AndreaBononi/MotionDetector/README.md

# MotionDetector
Motion detector board based on a PIR sensor
