AndreaBononi/MotionDetector/MotionDetector_technical_report.pdf

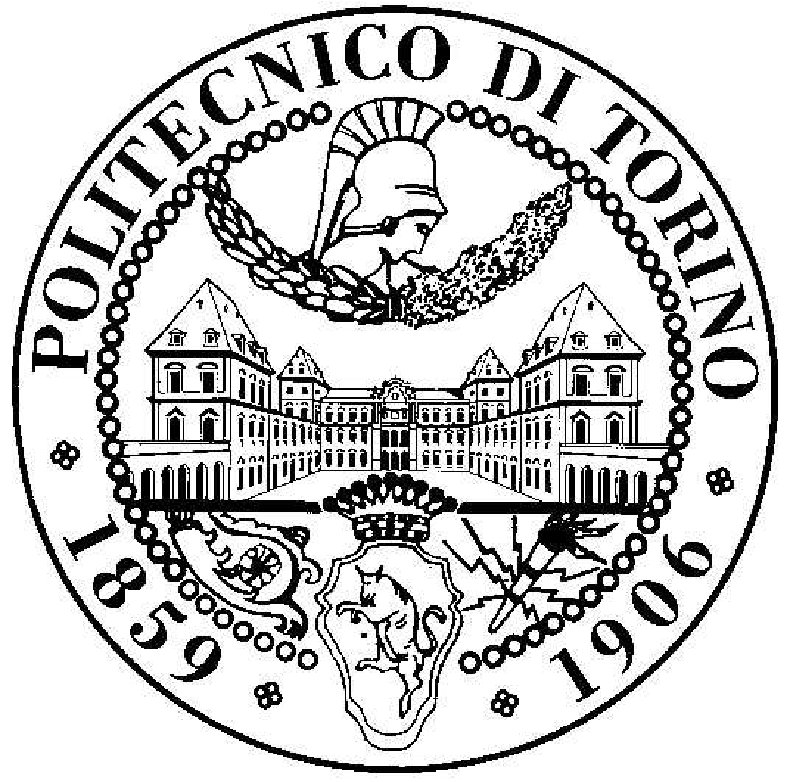
[picture p1: figure]

# Politecnico di Torino

## Electronic Systems Engineering

# ABDM ALARM

## BLUETOOTH MOTION DETECTOR WITH ACOUSTIC WARNING

## Author: Bononi Andrea (287628)

# CONTENTS

1 DEVICE OVERVIEW | 2
2 BILL OF MATERIALS | 4
3 SCHEMATICS | 5
4 BOARD LAYOUT | 10
5 CURRENT CONSUMPTION | 13
6 PRODUCTION COST ESTIMATION | 16
7 DESIGN HISTORY | 17

# DEVICE OVERVIEW

## 1.1 Description

The ABDM device is a cost-effective low power wireless intruder detector. When a movement is detected, an acoustic alarm is activated and a notice is immediately sent via Bluetooth to a dedicated Android application, from which it is possible to deactivate it (otherwise it will last 5 minutes once activated).

The detector can be enabled and disabled from the Android application. It can also be configured to automatically send an alert to a police station or to a specific phone number when an intrusion is detected.

The system is battery-powered. It is rechargeable by means of a common micro-USB connector and the battery status can be visualized in the Android application. A notification is sent when the battery charge level falls under a minimum threshold.

The Android application is called ABDM alarm, it can be downloaded for free from the offical Play Store and it can be periodically updated to newer versions (therefore, other functionalities may be developed in future without the need of changing the device).

## 1.2 Features

- Ultra-low power device
- Infrared movement detection

– Long distance detection (up to 7m) – Large field of view (90°)

- Battery-powered system

– 6 days duration

– Micro-USB connector for battery charge

– Capability of working while on charge

- BLE communication by means of a free Android application

– Immediate notification of a movement detection
– Capability of enabling/disabling the detection

– Battery charge status indication
– Immediate notification when the battery charge level falls under 10%
- Acoustic alarm

– 82db acoustic sound
– Automatic deactivation after 5 minutes
- Manual shutdown (mechanical switch) and reset (mechanical pushbutton)
- Device protection

– The switch and the pushbutton can be reached only by opening the device package
– The device package can only be opened with a suitable key (provided within the device itself)

CHAPTER 1. DEVICE OVERVIEW

## 1.3 Functional Block Diagram

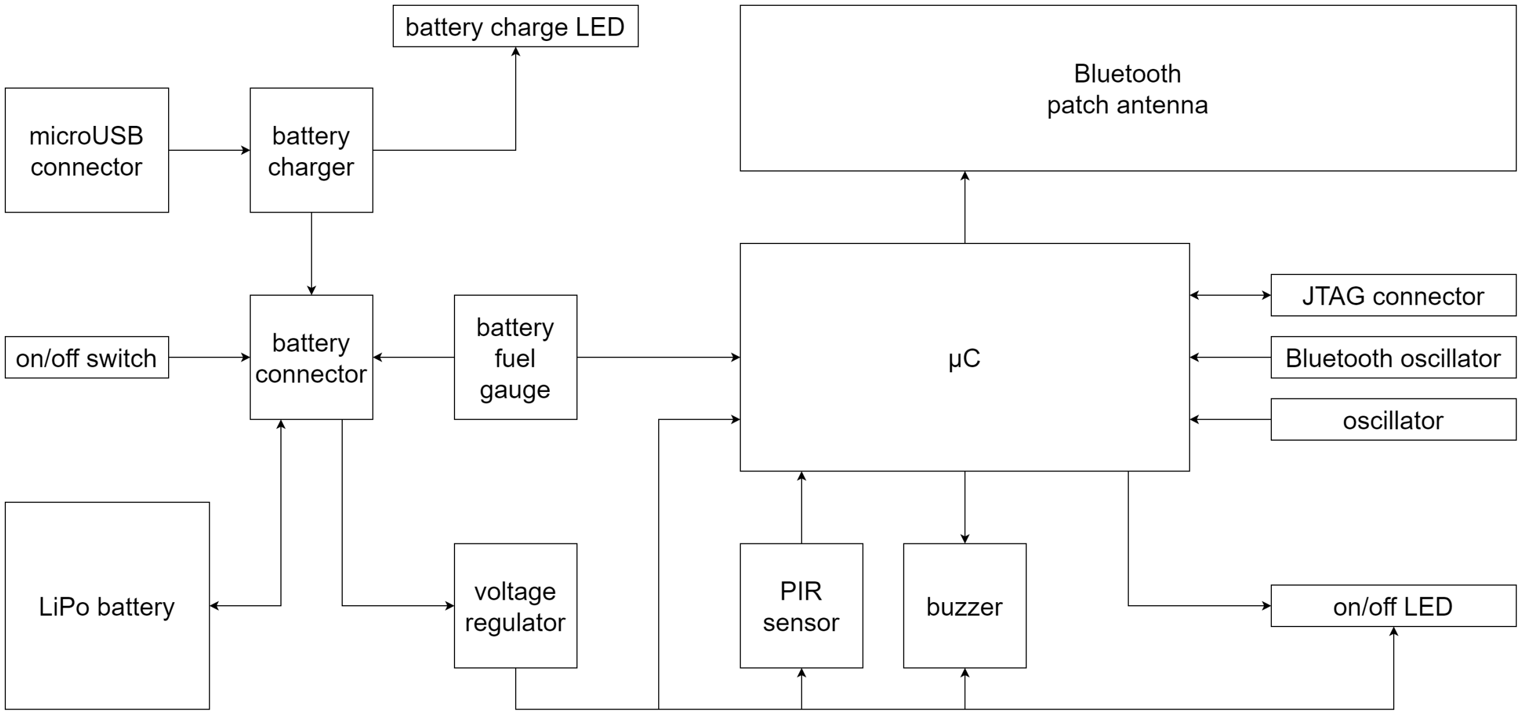
[picture p2: figure]

Figure 1.1: device functional block diagram

- An external LiPo battery is connected to the device through a battery connector and it can be recharged using an external 5V power source by means of a battery charger. The external power source is connected to the device through a microUSB connector. When the battery is on charge, the battery charge LED is turned on and the system is powered by the external source. The charge level of the battery is detected by means of a fuel gauge which communicates with the microcontroller using an I2C protocol.
- The on/off switch allows to disconnect the battery from the device, switching it off. The on/off LED is turned on when the device is powered.
- A voltage regulator (buck converter) is employed to convert the battery voltage (3.7V) or the esternal source voltage (5V) in a suitable value for the microcontroller and its external peripherals (3.3V).
- A PIR sensor is used for detecting any movement in the surrounding area (7m distance, 90° angle). The output is a simple digital signal (high if a movement is detected, low otherwise) compatible with the voltage levels of the microcontroller.
- An internally-driven electromechanical buzzer is employed to generate the acustic alarm when an intrusion is detected.
- The microcontroller is the real core of the system. It read the status of the PIR sensor and the status of the fuel gauge, it activates the buzzer when required and it manages the communication with the Android application via Bluetooth (it has an integrated BLE interface). It is programmed by means of a JTAG connector and it requires a generic esternal oscillator (24MHz) and a Bluetooth external oscillator (32.768 kHz). The BLE communication is realized using a suitable patch antenna.
- The device is incapsulated inside a safety box, which can be opened using the key provided to the customer with the device itself. The LEDs status can be seen from the otuside, but the mechanical switch cannot be reached without opening the box.

# BILL OF MATERIALS

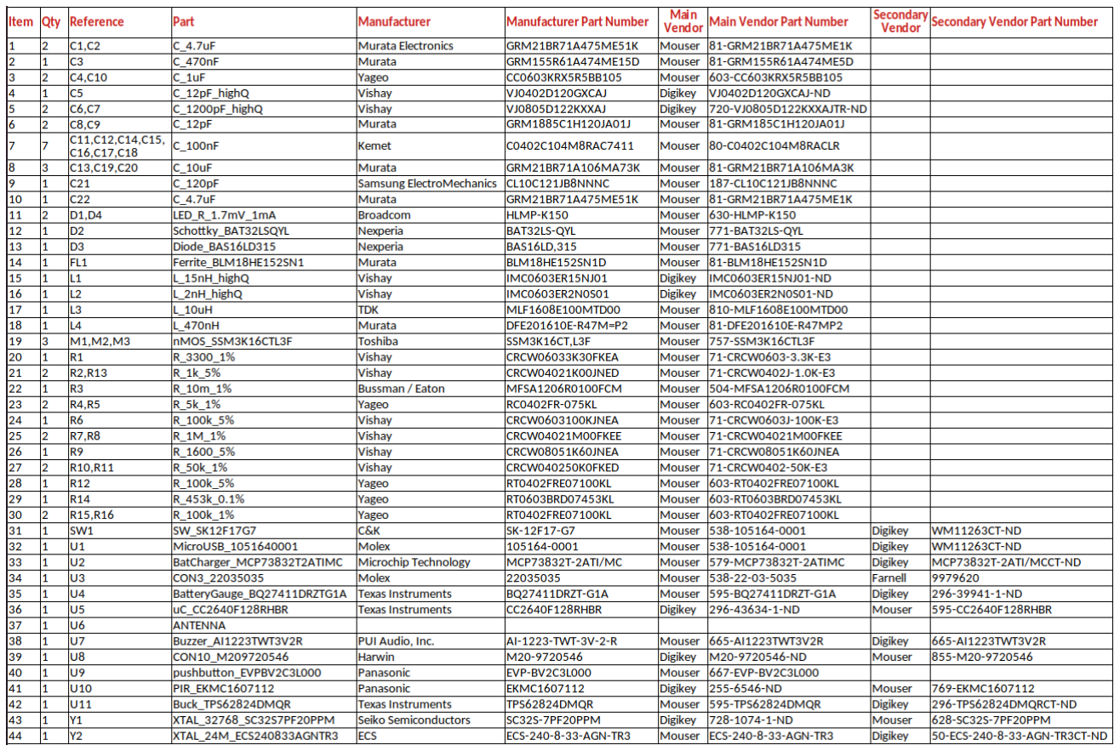
[picture p3: figure]

The previous table contains all the components employed in the board fabrication. However, it is also necessary to include in the list the battery, which is external with respect to the board but necessary to make it work:

LiPo battery (3.7 V, 980 mAh) Manufacturer: BAK
Manufacturer product number: LP-523450-IS-3 Vendor: Farnell
Vendor part number: 2077888

# SCHEMATICS

## 3.1 Battery Management Section

The battery voltage is provided to the board using a rectangular connector, whereas the charging voltage is provided by means of a micro-USB connector. When the charging voltage is present the battery is recharged, the charge LED is turned on and the system is powered by this voltage instead of the battery voltage. The battery charge level is detected by the gauge, which measures the current flowing through a sense resistor. The mechanical switch allows to disconnect the battery voltage from the rest of the circuit, turning it off.

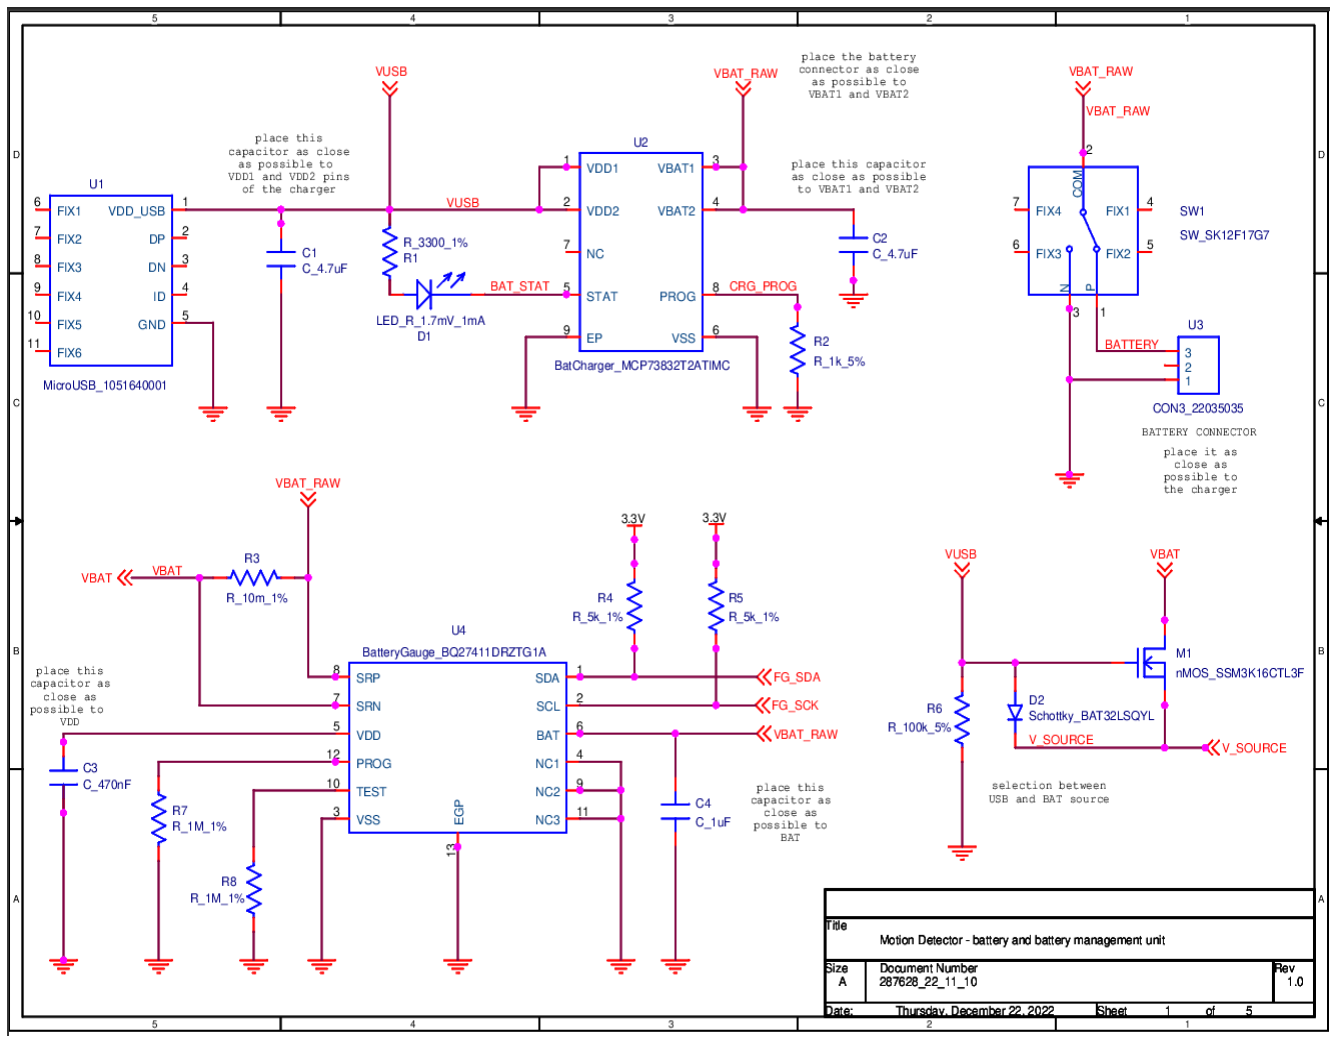
[picture p4: figure]

Figure 3.1: Battery management section

- The value of the resistor in series to the LED is such that the current flowing through it and its voltage drop are capable of turning it on. If necessary, both the LED and the resistor can be substituted with different commercial parts as long as the LED can be turned on using VUSB = 5 V and as long as the power consumption is not significantly increased.
- The MOS transistor and the Schottky diode allows the selection between the USB voltage and the battery voltage. They can be substituted with any other commercial parts as long as they are able to withstand a suitable power consumption (all the current required by the device flows through them).

CHAPTER 3. SCHEMATICS

- All the passive parts (resistors and capacitors) can be substituted with equivalent commercial parts. Their uncertainty is not really important, with the exception of the sense resistor (whose uncertainty must be equal or lower than 1%). It is recommended to use X5R or X7R decoupling capacitors.

## 3.2 Microcontroller Section

The main clock and the Bluetooth clock are provided using two suitable crystal oscillators. The RF communication is realized employing a patch antenna with a single-ended connection (4XS).

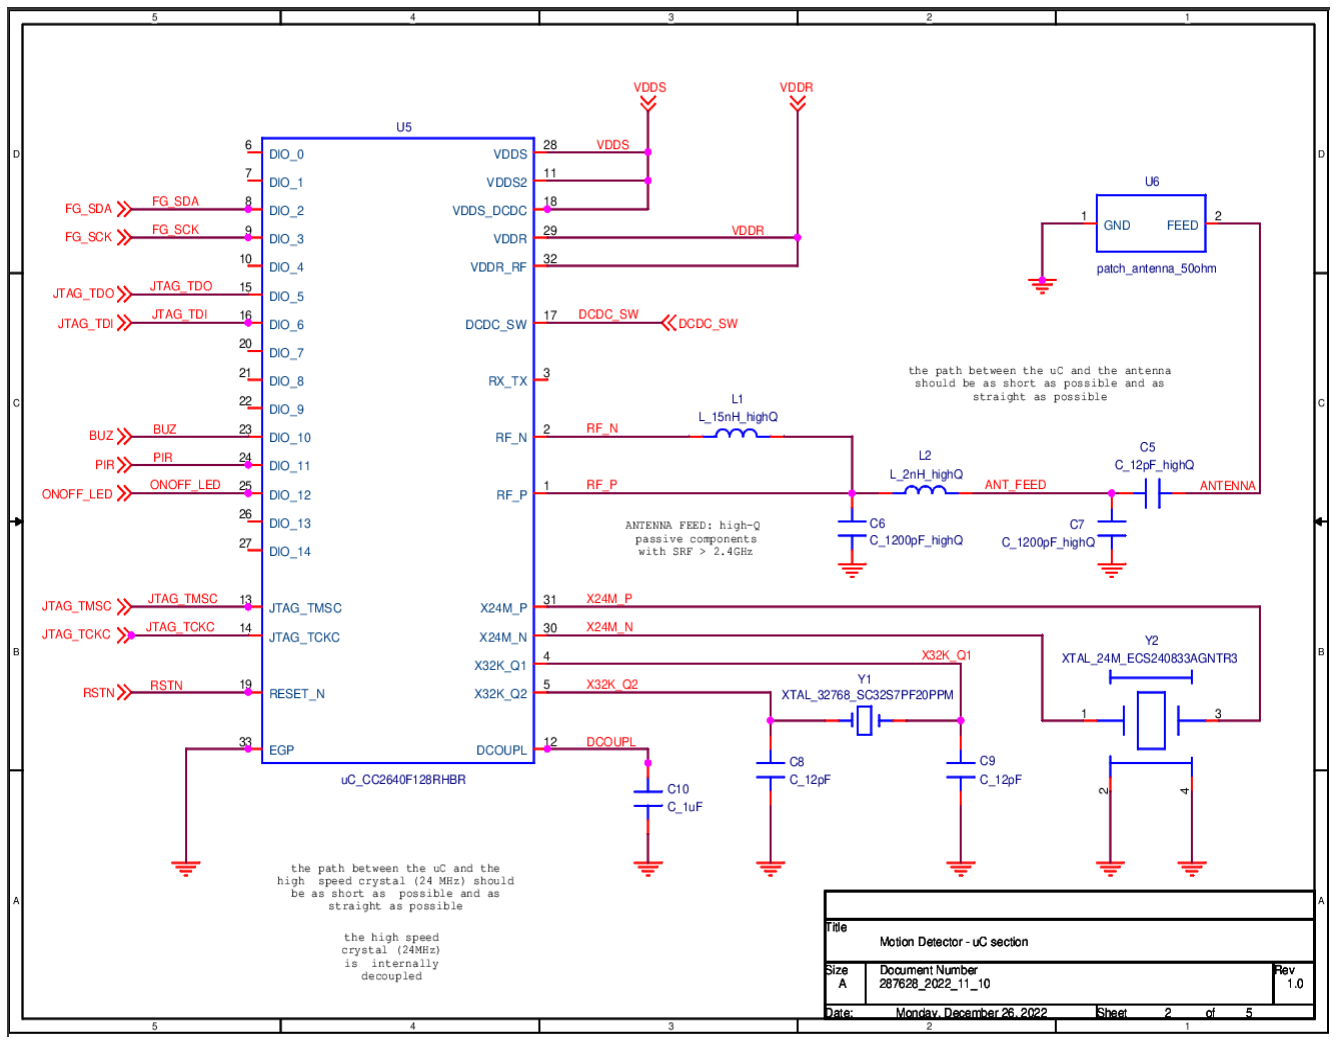
[picture p5: figure]

Figure 3.2: Microcontroller section

- The oscillators are chosen in order to respect the requirements stated by the manufacturer of the CC2640 microcontroller. They can be susbtituted with any other part which respects these requirements.
- The components employed in the antenna feed are characterized by a self-resonant frequency higher than the antenna freqeuncy (2.4 GHz) and by a high quality factor. They can be substituted with any other commercial part respecting these requirements.
- All the passive components related to the decoupling network can be substituted with equivalent commercial parts. Their uncertainty is not really important. It is recommended to use X5R or X7R capacitors.

CHAPTER 3. SCHEMATICS

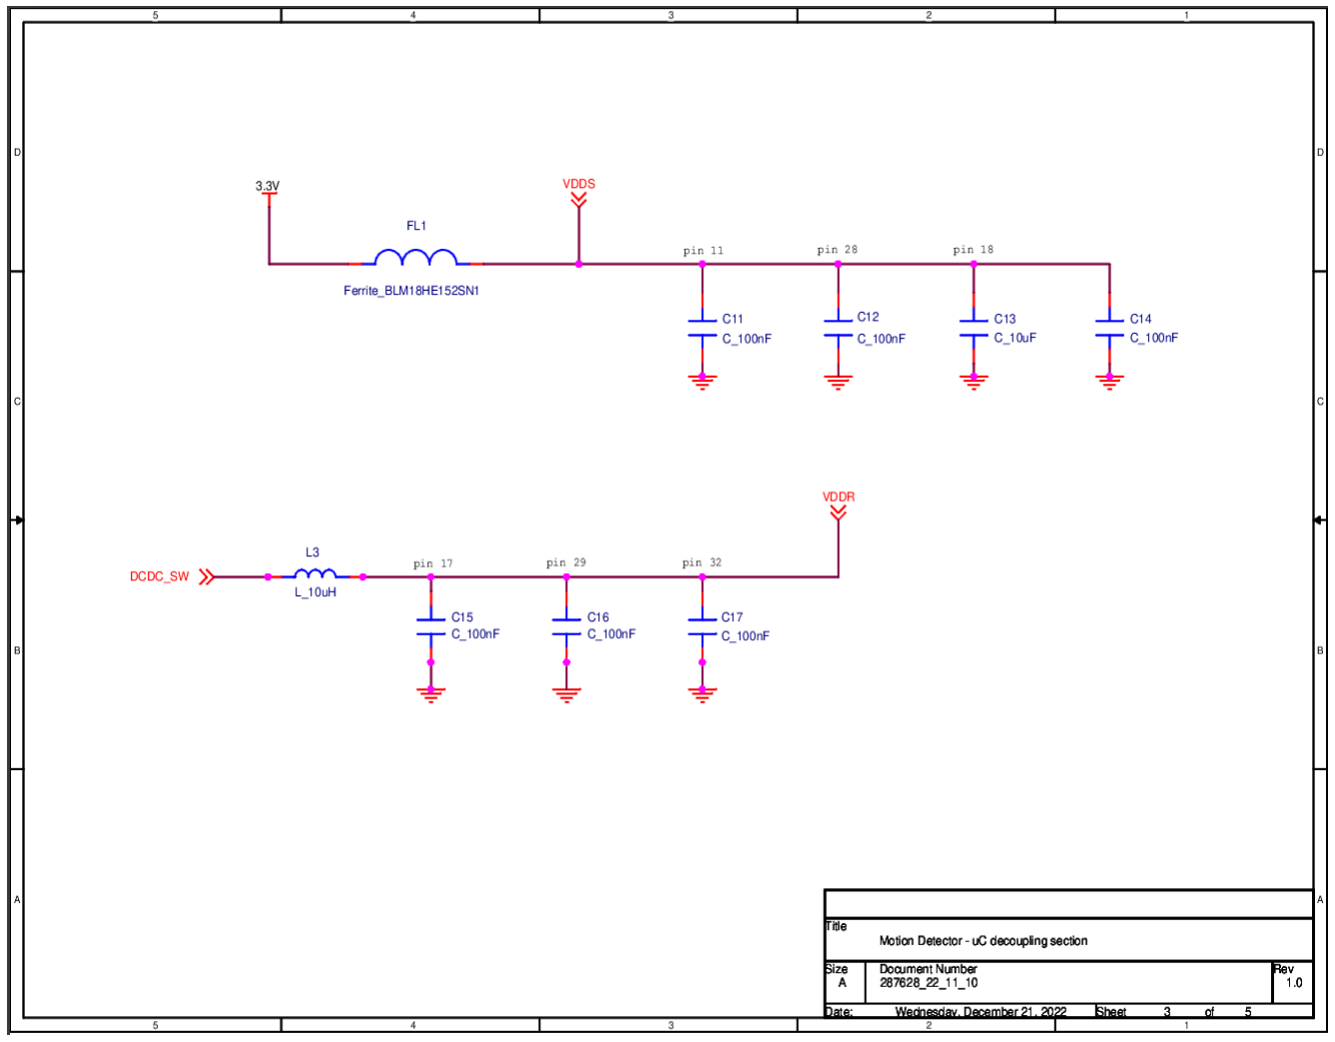
[picture p6: figure]

Figure 3.3: Microcontroller decoupling

## 3.3 Peripherals

The electromechanical buzzer is internally-driven, i.e. it just requires a continuous current in order to be activated. However, the required current is too high to be provided directly by the microcontroller, therefore a simple driver is realized exploiting a MOSFET transistor in common source configuration. A resistor is inserted in series to the transistor gate in order to limit the instantaneous current during the commutations, whereas a protecting diode is inserted in parallel to the buzzer (being it an inductive load).

Similarly to the buzzer case, the current required by the ON-OFF LED is too high, therefore the same driver is employed (without the protectiong diode, since the LED is not an inductive load). Moreover, a proper resistor is inserted in series to the LED in order to obtain the voltage drop and the current flow capable of turning it on.

The output current of the PIR sensor is perfectly maneageable by the microcontroller (since it is low enough), therefore it is not necessary to insert any other circuit.

The microcontroller programming is managed through a JTAG connection, which is realized by means of a pin-strip connector with 10 positions. The extra pins (other than the 4 pins required by the JTAG protocol) are not used at the moment, but they might be employed in future releases to implement different functionalities.

The mechanical pushbutton allows to manually reset the microcontroller. A series resistor is inserted in order to limit the current flowing through the pushbutton.

CHAPTER 3. SCHEMATICS

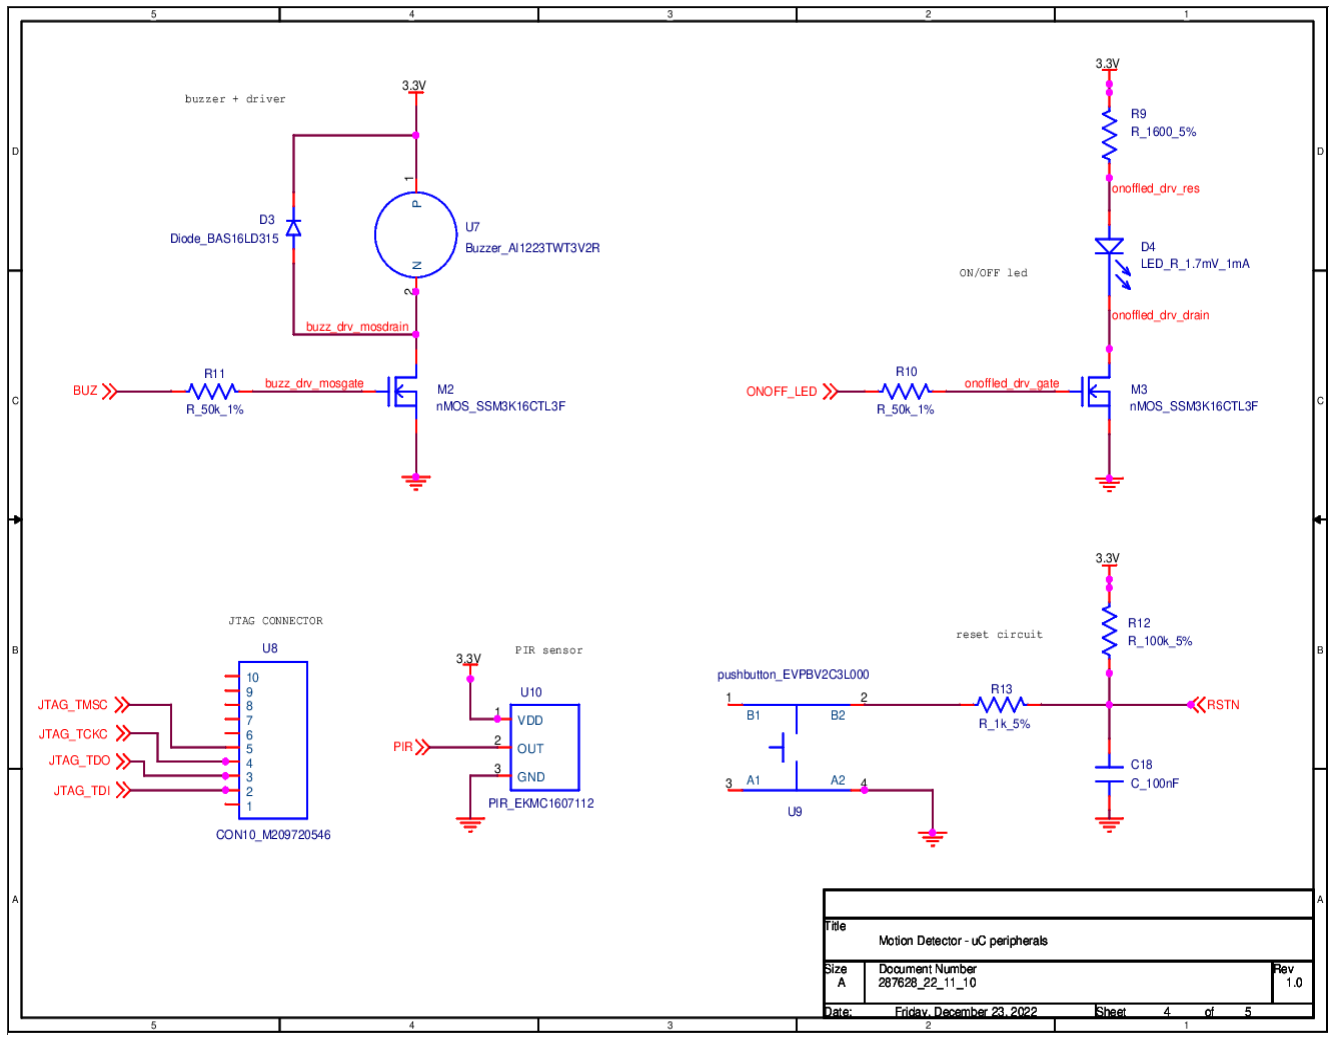
[picture p7: figure]

Figure 3.4: Peripherals

- Both the LED and its series resistor can be substituted with different commercial parts as long as the LED can be turned on using VDDS = 3.3 V and as long as the power consumption is not significantly increased.
- The protecting diode can be substituted with any other commercial part witha high enough breakdown voltage.
- The MOS transistor can be substituted with any other equivalent commercial part as long as its threshold voltage is compatible with the microcontroller output voltage.
- All the passive components (resistors and capacitors) can be substituted with equivalent commercial parts (their uncertainty is not really important).

## 3.4 Voltage Regulator

A buck converter is used to transform the battery voltage in a stable value that can be employed by the microcontroller and its peripherals, i.e. 3.3V. The regulation of the output voltage of the buck is obtained by means of a resistor divider, which means that its uncertainty depends on the uncertainty of the employed resistors. For this reason, the resistors can be substituted with any other equivalent commercial part as long as the uncertainty is acceptable. When it comes to the capacitors, the uncertainty is not really important, therefore they can be easily substituted with different commercial parts (it is recommented to use X5R or X7R capacitors).

CHAPTER 3. SCHEMATICS

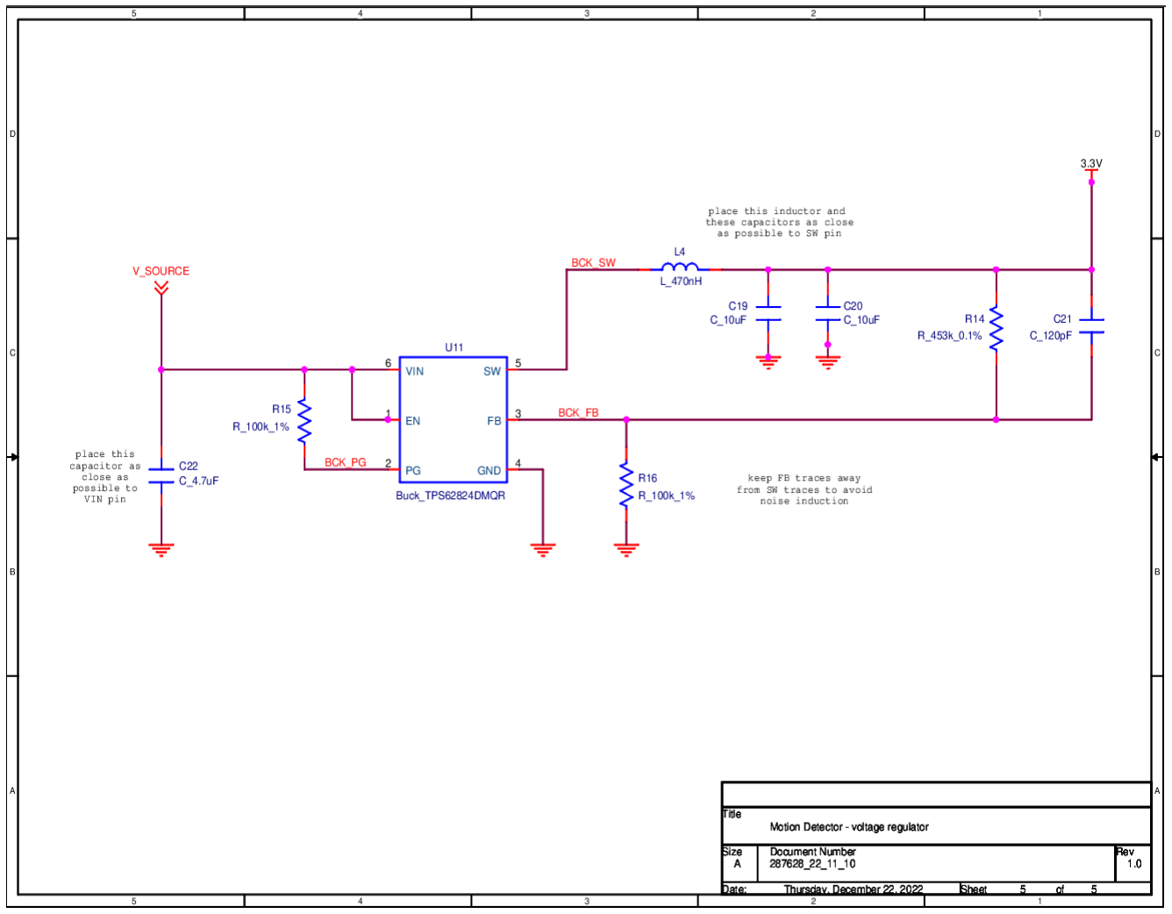
[picture p8: figure]

Figure 3.5: Voltage regulator section

# BOARD LAYOUT

The PCB is a 2-layer board. The bottom layer is mainly dedicated to the ground plane; indeed, it does not contain any component, the number of traces on it has been reduced to the minimum and the same goes for their lenght. Wider traces have been employed for power supply lines whenever it was possible in order to reduce their resistance. The whole board is compliant with the specifications provided by the manufacturer (EUROCIRCUITS).

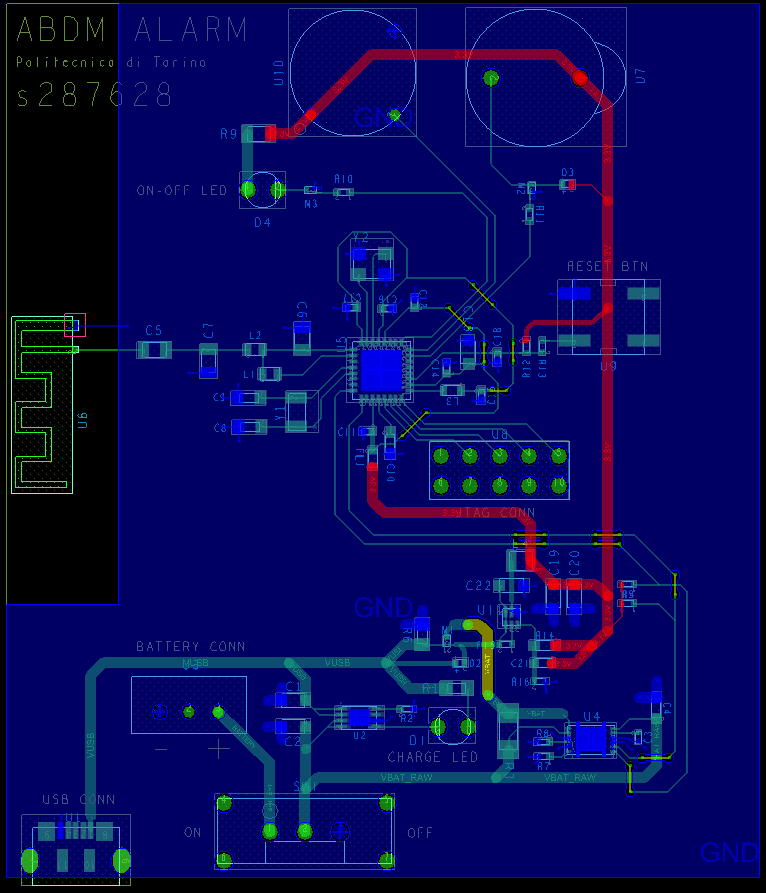
[picture p9: figure]

Figure 4.1: Board layout

CHAPTER 4. BOARD LAYOUT

All the components have been placed according to datasheets recommendations. The decoupling capacitors have been kept as close as reasonably possible to the decoupled pin of the related IC and each of them is connected to the ground plane by means of one or more dedicated VIAs. The antenna has been positioned in a dedicated area without any component or trace nearby and the ground plane has been removed in the region below it. The antenna feed is completely straight, it does not contain VIAs and it is not crossed by any bottom trace; moreover, all the components of the antenna feed are characterized by a self-resonant frequency greater than the antenna frequency (2.4 GHz).

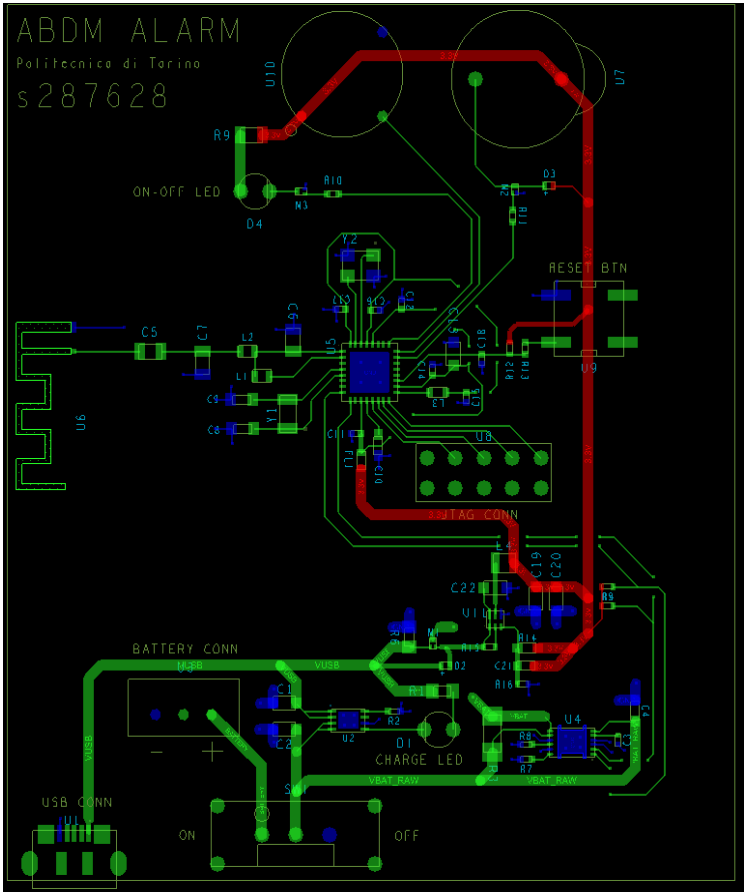
[picture p10: figure]

Figure 4.2: Board layout - top view

CHAPTER 4. BOARD LAYOUT

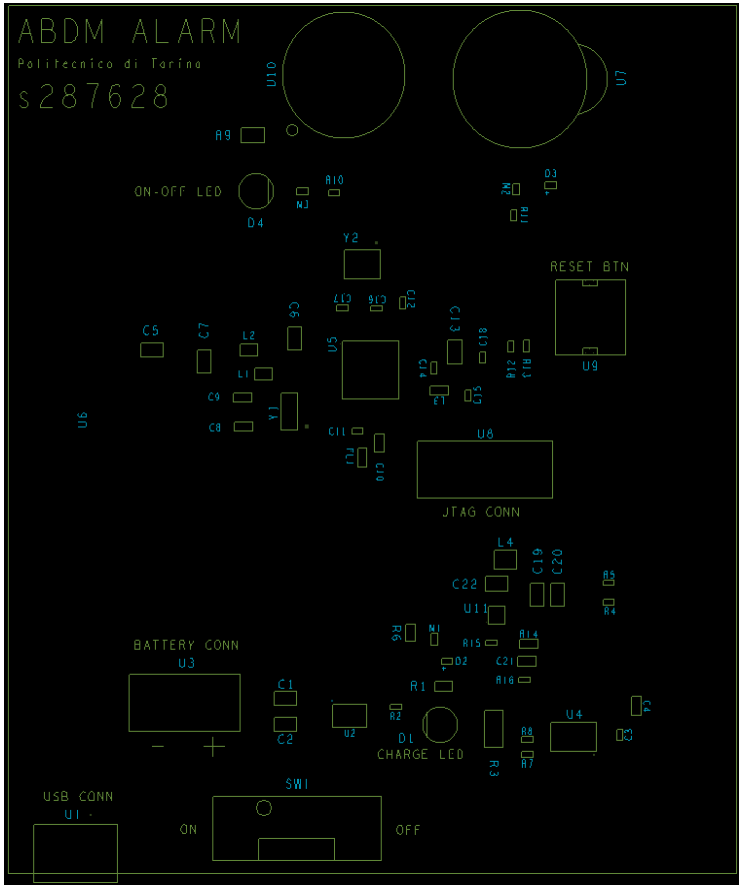
[picture p11: figure]

Figure 4.3: Board layout - top view

# CURRENT CONSUMPTION

## 5.1 Microcontroller

The CC2640 current consumption depends on which of its components are in use:

ITOTAL = ICORE + IPERI

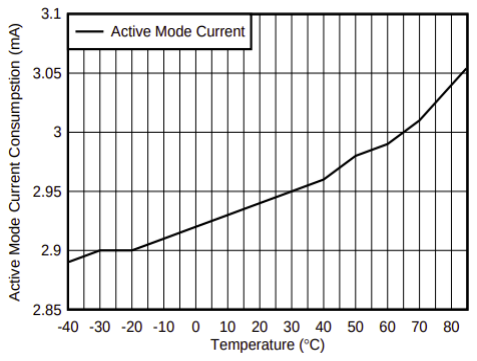
[picture p12: figure]

Figure 5.1: ICORE(T) at VDDS = 3V and FCLK = 24MHz in active mode (no RF)

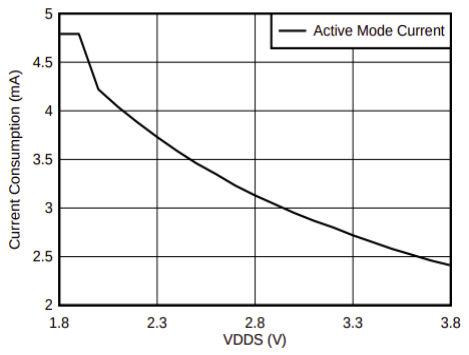
[picture p13: figure]

Figure 5.2: ICORE(VDDS) at T = 25◦ and FCLK = 24MHz in active mode (no RF)

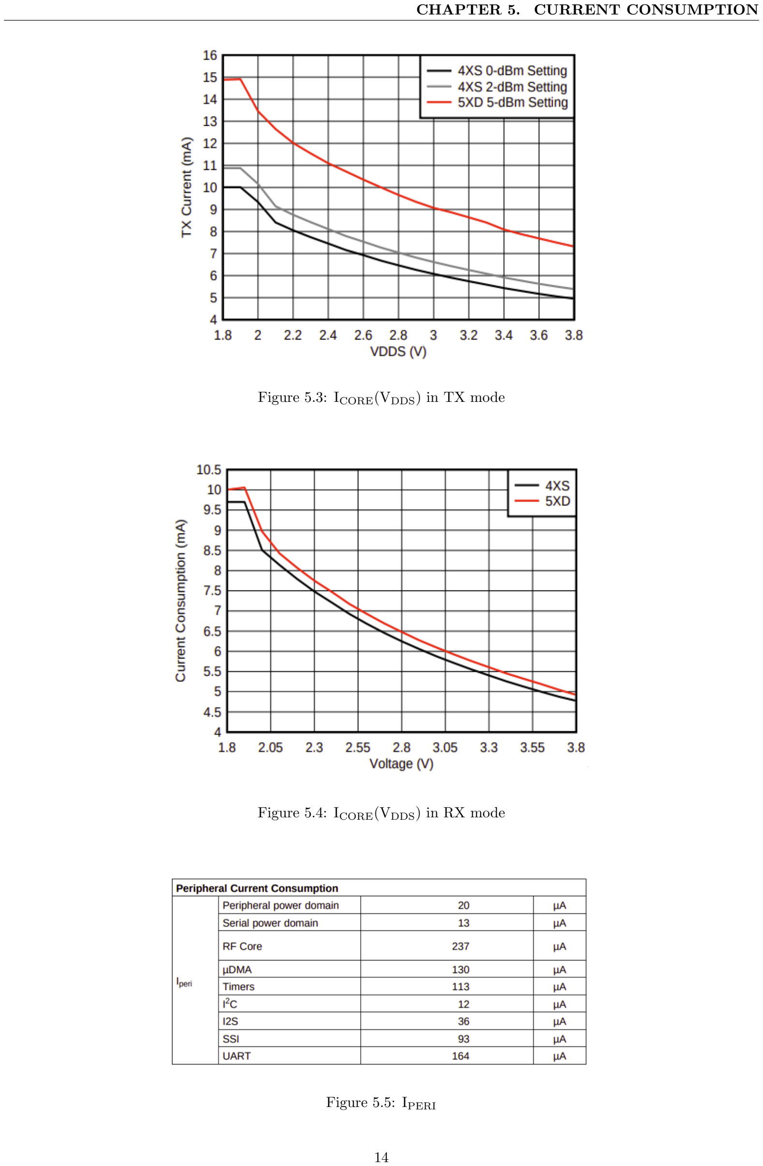
[picture p14: page 15]

CHAPTER 5. CURRENT CONSUMPTION

Figure 5.3: ICORE(VDDS) in TX mode

Figure 5.4: ICORE(VDDS) in RX mode

Figure 5.5: IPERI

CHAPTER 5. CURRENT CONSUMPTION

In our case, the microcontroller goes in TX mode only when the battery charge status is updated (i.e. once per 10 minutes), when a movement is detected and to notify the user when the detection is turned on or off, therefore we can neglect the TX mode contribution to the average current consumption. On the other hand, the user might send a command from the application at any moment (for instance to disable the detection), which means that the microcontroller must constantly remain in RX mode.

Considering VDDS = 3.3V and a 4XS antenna configuration (i.e. a single-ended connection, which is the one employed in our case) and assuming a temperature of 25 degrees:

ICORE AVG ≈ ICORE RX = 5.4 mA

IPERI = IPERI PWR DOM + ISER PWR DOM + IRF CORE + ITIMERS + II2C = 0.395 mA

IµC ≈ 5.8 mA

## 5.2 LEDs

The current consumption of each HLMP-K150 LED is equal to 1 mA while active. However, both the LEDs blink with a 50% duty cycle (the frequency is high enough so that the human eye is not able to perceive the blinking), therefore the averege current is equal to 0.5 mA per LED.

## 5.3 Buzzer

The current consumption of the electromechanical buzzer is equal to 30 mA while active. However, the buzzer is intermittedly turned on for maximum 5 minutes (duty cycle 50%) only when a movement is detected, which is a quite rare occasion. Assuming the detection of 4 intrusion per day (although this number is usually lower in reality), the average current is equal to 0.21 mA.

## 5.4 Total current consumption and battery duration

All the components which are not related to the battery management are powered by means of the voltage regulator output (which is characterized by an efficiency η ≈ 0.9):

IOUT REG ≈ IµC + IPIR + ION OFF LED ≈ 5.8 mA + 0.3 mA + 0.5 mA = 6.6 mA

IIN REG · VBAT = PIN REG =

POUT REG
η

=

IOUT REG · VDDS
η

IIN REG =

IOUT REG · VDDS
η · VBAT

≈

6.6 mA · 3.3 V
0.9 · 3.7 V

≈ 6.54 mA

Considering also the battery management components we can estimate the total current consumption and the battery duration:

IOUT BAT ≈ IIN REG + ICHARGER + IGAUGE ≈ 6.54 mA + 0.002 mA + 0.093 mA = 6.635 mA

Battery Duration ≈

980 mAh
6.635 mA = 147.7 h = 6.15 days

# PRODUCTION COST ESTIMATION

The following evaluation is performed under the assumption of producing 1000 units. A higher production may lead to an inferior price, whereas a lower production can significantly increase the final cost.

- Microcontroller: 3.98e
- PIR sensor: 6.71e
- Buzzer: 0.68e
- Battery: 13.69e
- Battery charger: 0.645e
- Battery fuel gauge: 1.65e
- Voltage regulator: 0.635e
- Switch: 0.55e
- Pushbutton: 0.35e
- LEDs: 0.166e
- Oscillator (24MHz): 0.224e
- Oscillator (32.768 kHz): 0.215e
- Micro-USB connector: 0.632e
- JTAG connector: 0.257e
- Battery connector: 0.133e
- Capacitors: 0.92e
- Inductors: 0.52e
- Resistors: 0.264e
- Other: 0.47e
- TOTAL PRODUCTION COST: 32.70e

# DESIGN HISTORY

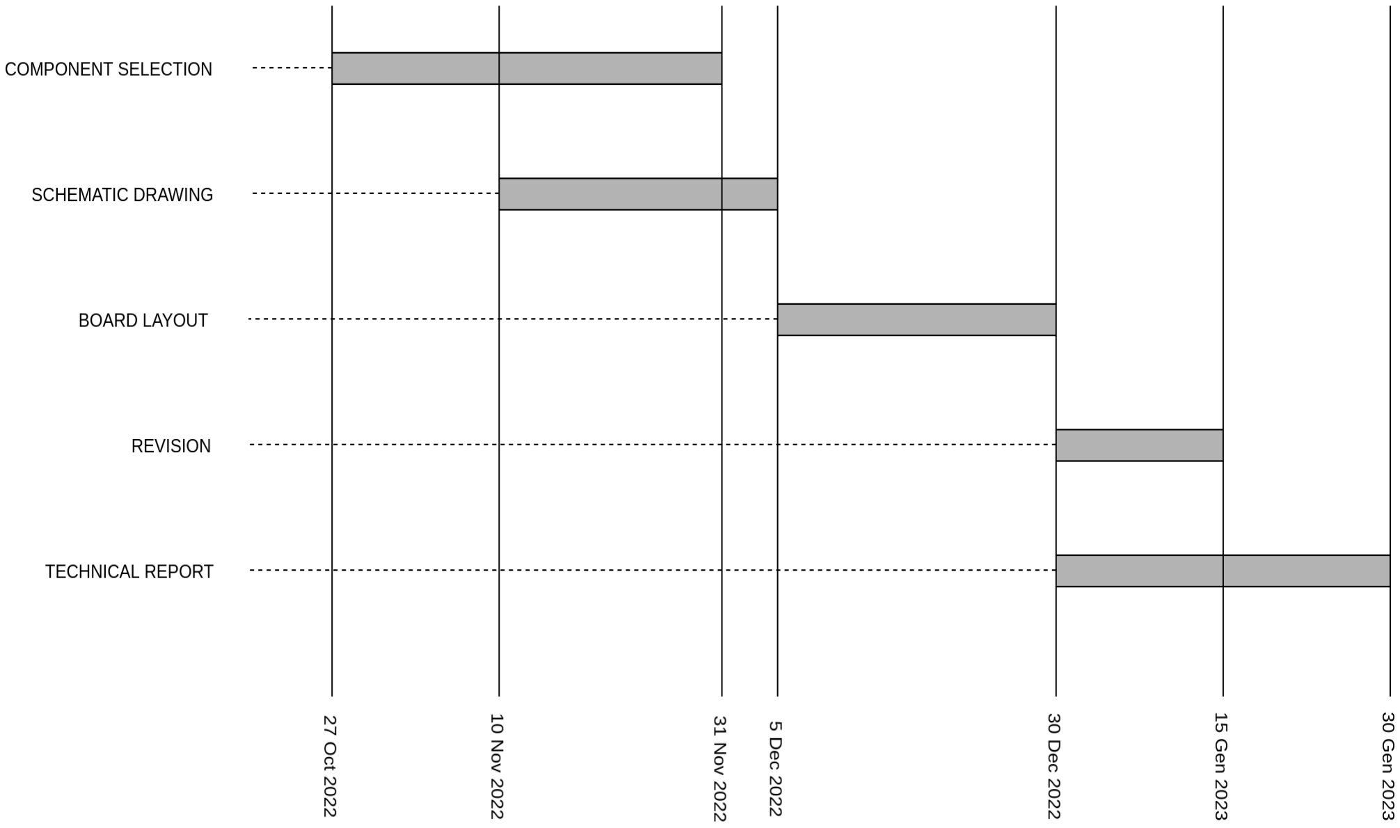
[picture p15: figure]

Figure 7.1: GANTT diagram
