AndreaBononi/MotionDetector/(list of files, cad)

Other CAD files:
project/OrCAD_Personal_Library/Footprints/1051640001.psm
project/OrCAD_Personal_Library/Footprints/22035035.psm
project/OrCAD_Personal_Library/Footprints/ai1223twt3v2r.psm
project/OrCAD_Personal_Library/Footprints/bas16ld315.psm
project/OrCAD_Personal_Library/Footprints/bat32lsqyl.psm
project/OrCAD_Personal_Library/Footprints/blm18he152sn1d.psm
project/OrCAD_Personal_Library/Footprints/bq27411drztg1a.psm
project/OrCAD_Personal_Library/Footprints/c0402c104m8rac7411.psm
project/OrCAD_Personal_Library/Footprints/cc0603krx5r5bb105.psm
project/OrCAD_Personal_Library/Footprints/cl10c121jb8nnnc.psm
project/OrCAD_Personal_Library/Footprints/crcw04021k00jned.psm
project/OrCAD_Personal_Library/Footprints/crcw04021m00fkee.psm
project/OrCAD_Personal_Library/Footprints/crcw040250k0fked.psm
project/OrCAD_Personal_Library/Footprints/crcw0603100kjnea.psm
project/OrCAD_Personal_Library/Footprints/crcw06033k30fkea.psm
project/OrCAD_Personal_Library/Footprints/crcw08051k60jnea.psm
project/OrCAD_Personal_Library/Footprints/dfe201610e.psm
project/OrCAD_Personal_Library/Footprints/ecs240833agntr.psm
project/OrCAD_Personal_Library/Footprints/ekmc1607112.psm
project/OrCAD_Personal_Library/Footprints/evpbv2c3l000.psm
project/OrCAD_Personal_Library/Footprints/footprint_cc2640f128rhbr.psm
project/OrCAD_Personal_Library/Footprints/grm155r61a474me15d.psm
project/OrCAD_Personal_Library/Footprints/grm1885c1h120ja01j.psm
project/OrCAD_Personal_Library/Footprints/grm21br71a106ma73k.psm
project/OrCAD_Personal_Library/Footprints/grm21br71a475me51k.psm
project/OrCAD_Personal_Library/Footprints/hlmpk150.psm
project/OrCAD_Personal_Library/Footprints/imc0603er15nj01.psm
project/OrCAD_Personal_Library/Footprints/imc0603er2n0s01.psm
project/OrCAD_Personal_Library/Footprints/m209720546.psm
project/OrCAD_Personal_Library/Footprints/mcp73832t2atimc.psm
project/OrCAD_Personal_Library/Footprints/mfsa1206r0100fcm.psm
project/OrCAD_Personal_Library/Footprints/mlf1608e100mtd00.psm
project/OrCAD_Personal_Library/Footprints/patch_antenna_50ohm.psm
project/OrCAD_Personal_Library/Footprints/rc0402fr075kl.psm
project/OrCAD_Personal_Library/Footprints/rt0402fre07100kl.psm
project/OrCAD_Personal_Library/Footprints/rt0603brd07453kl.psm
project/OrCAD_Personal_Library/Footprints/sc32s7pf20ppm.psm
project/OrCAD_Personal_Library/Footprints/sk12f17g7.psm
project/OrCAD_Personal_Library/Footprints/ssm3k16ct.psm
project/OrCAD_Personal_Library/Footprints/tps62824dmqr.psm
project/OrCAD_Personal_Library/Footprints/vj0402d120gxcaj.psm
project/OrCAD_Personal_Library/Footprints/vj0805d122kxxaj.psm
