AndreaBononi/MotionDetector/MotionDetector_schematics.pdf

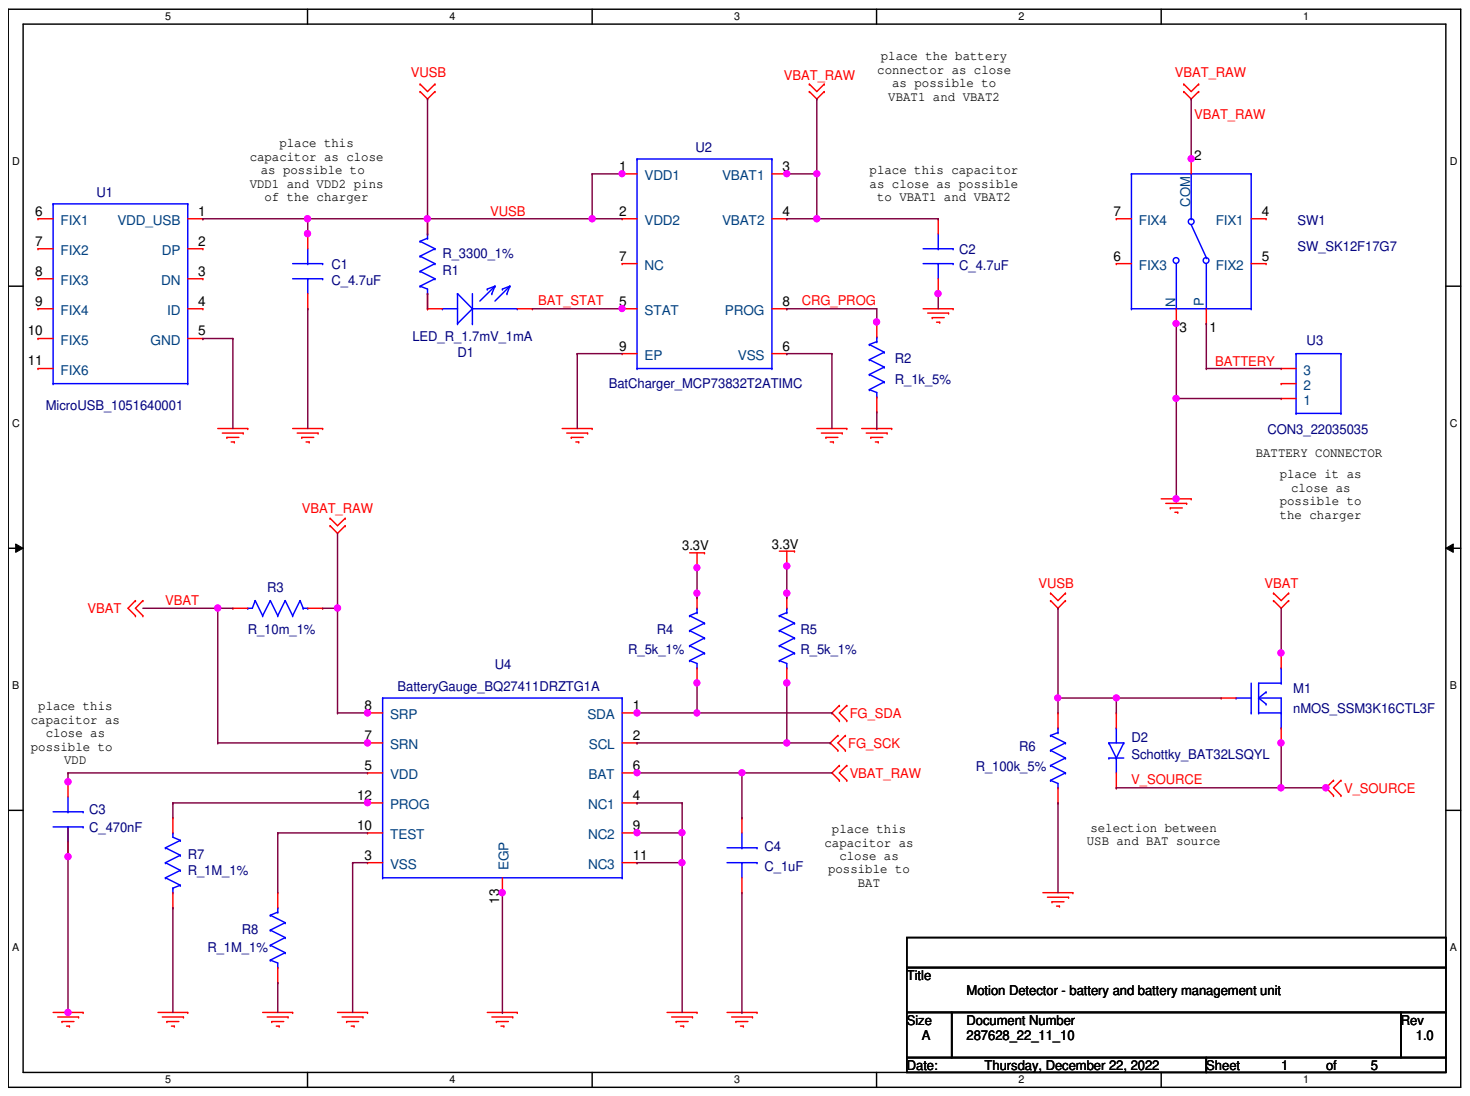
[picture p23: page 1]

place this capacitor
as close as possible
to VBAT1 and VBAT2

selection between
USB and BAT source

Motion Detector - battery and battery management unit

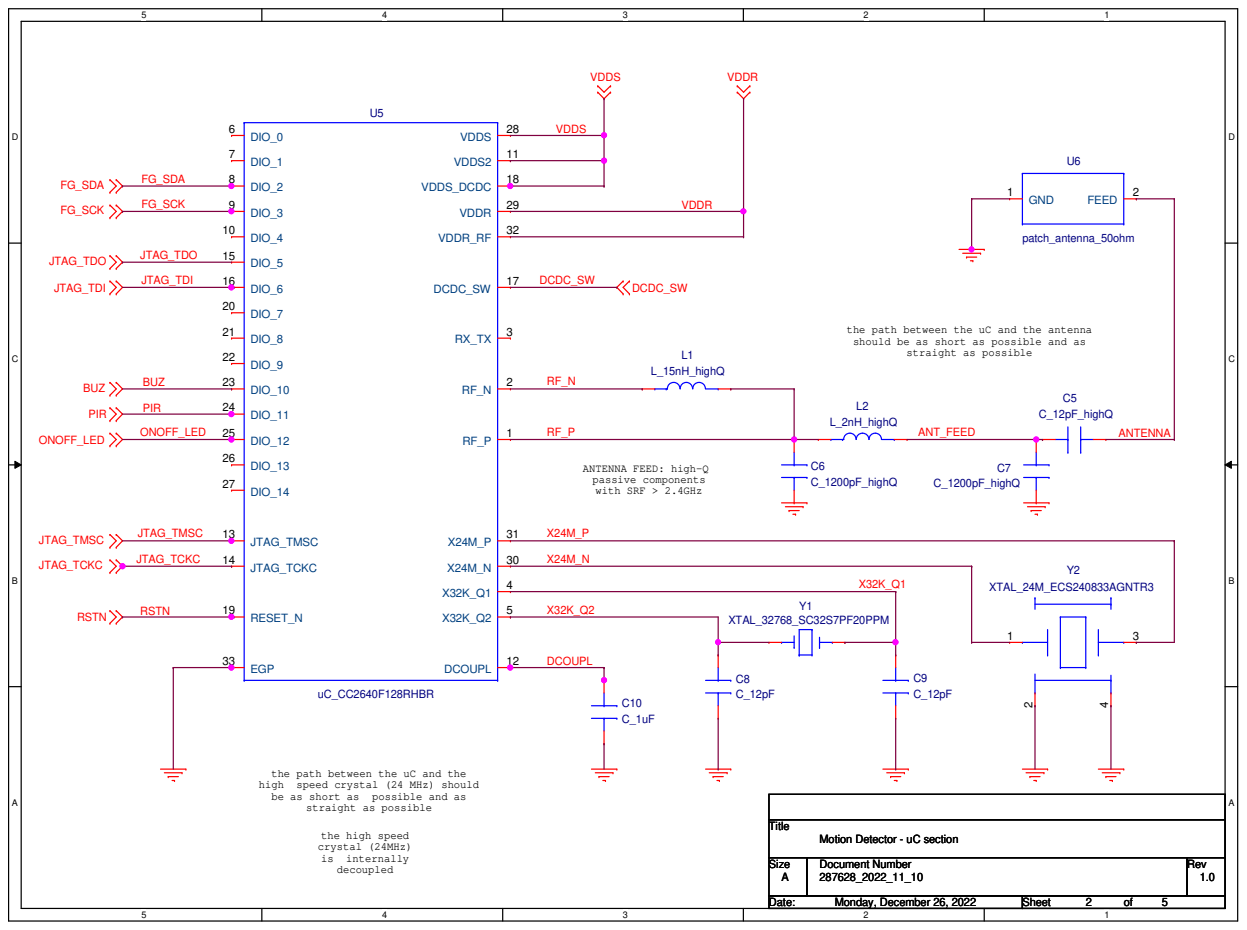
[picture p24: page 2]

the path between the uC and the antenna
should be as short as possible and as

the path between the uC and the

Motion Detector - uC section

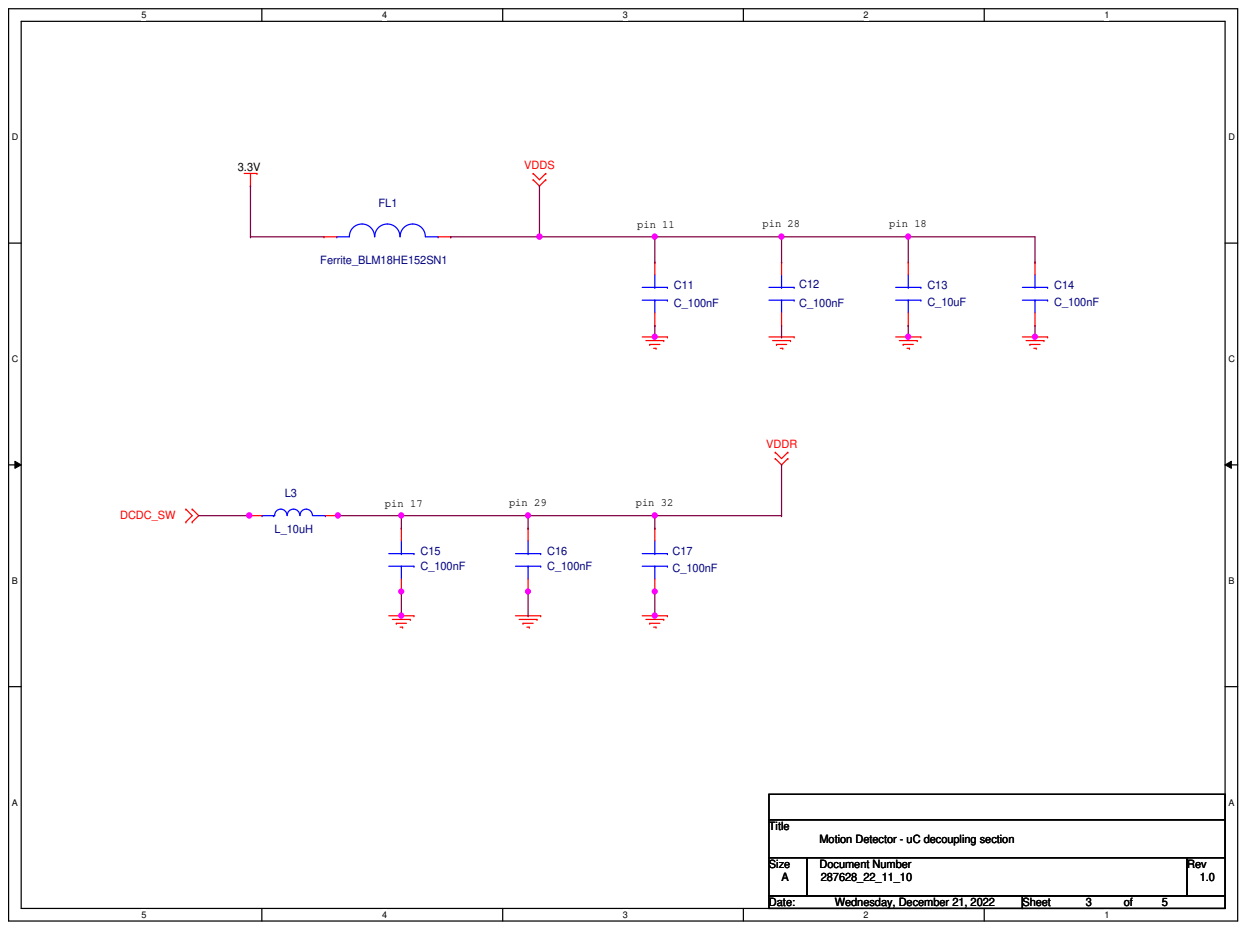
[picture p25: page 3]

Motion Detector - uC decoupling section

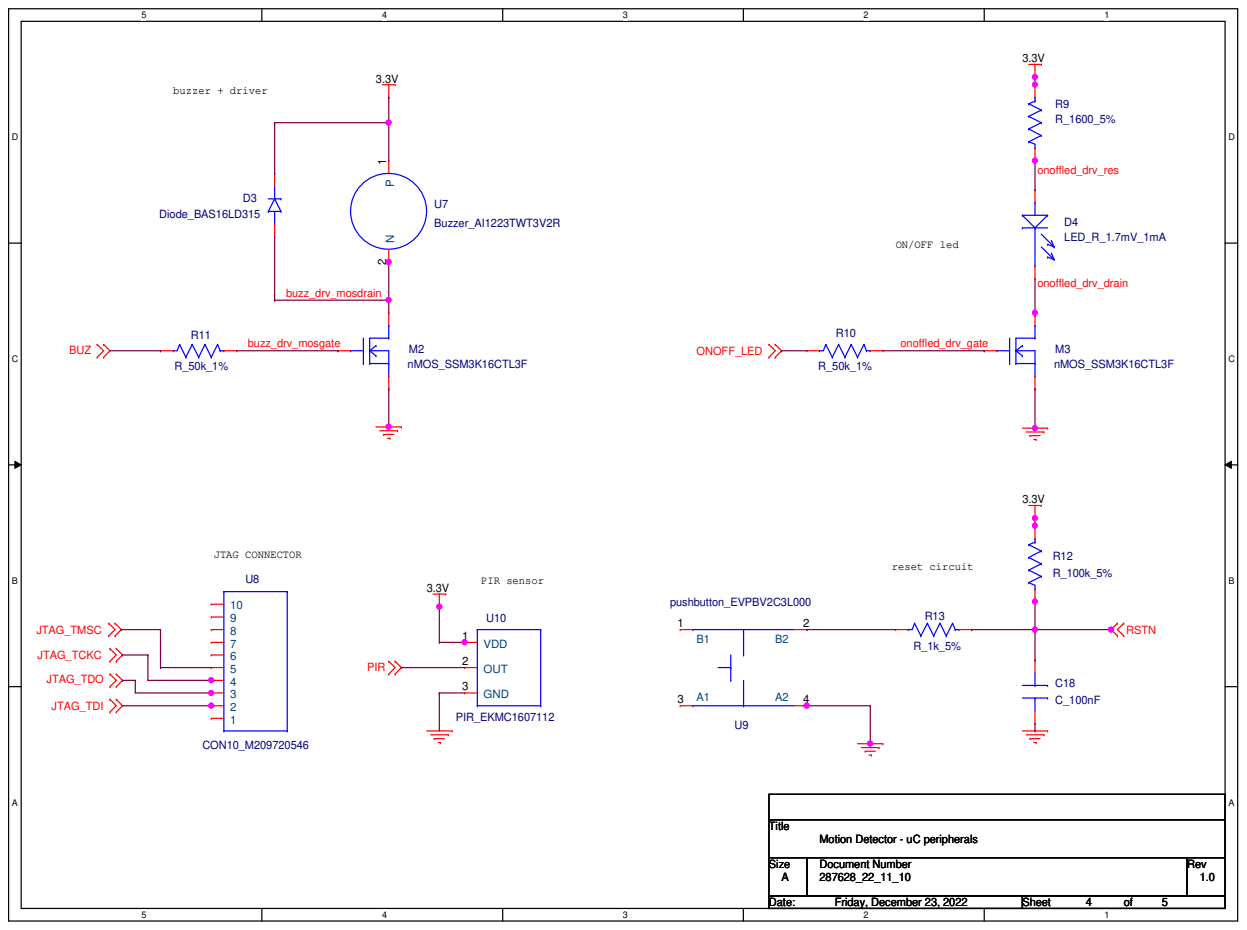
[picture p26: page 4]

Motion Detector - uC peripherals

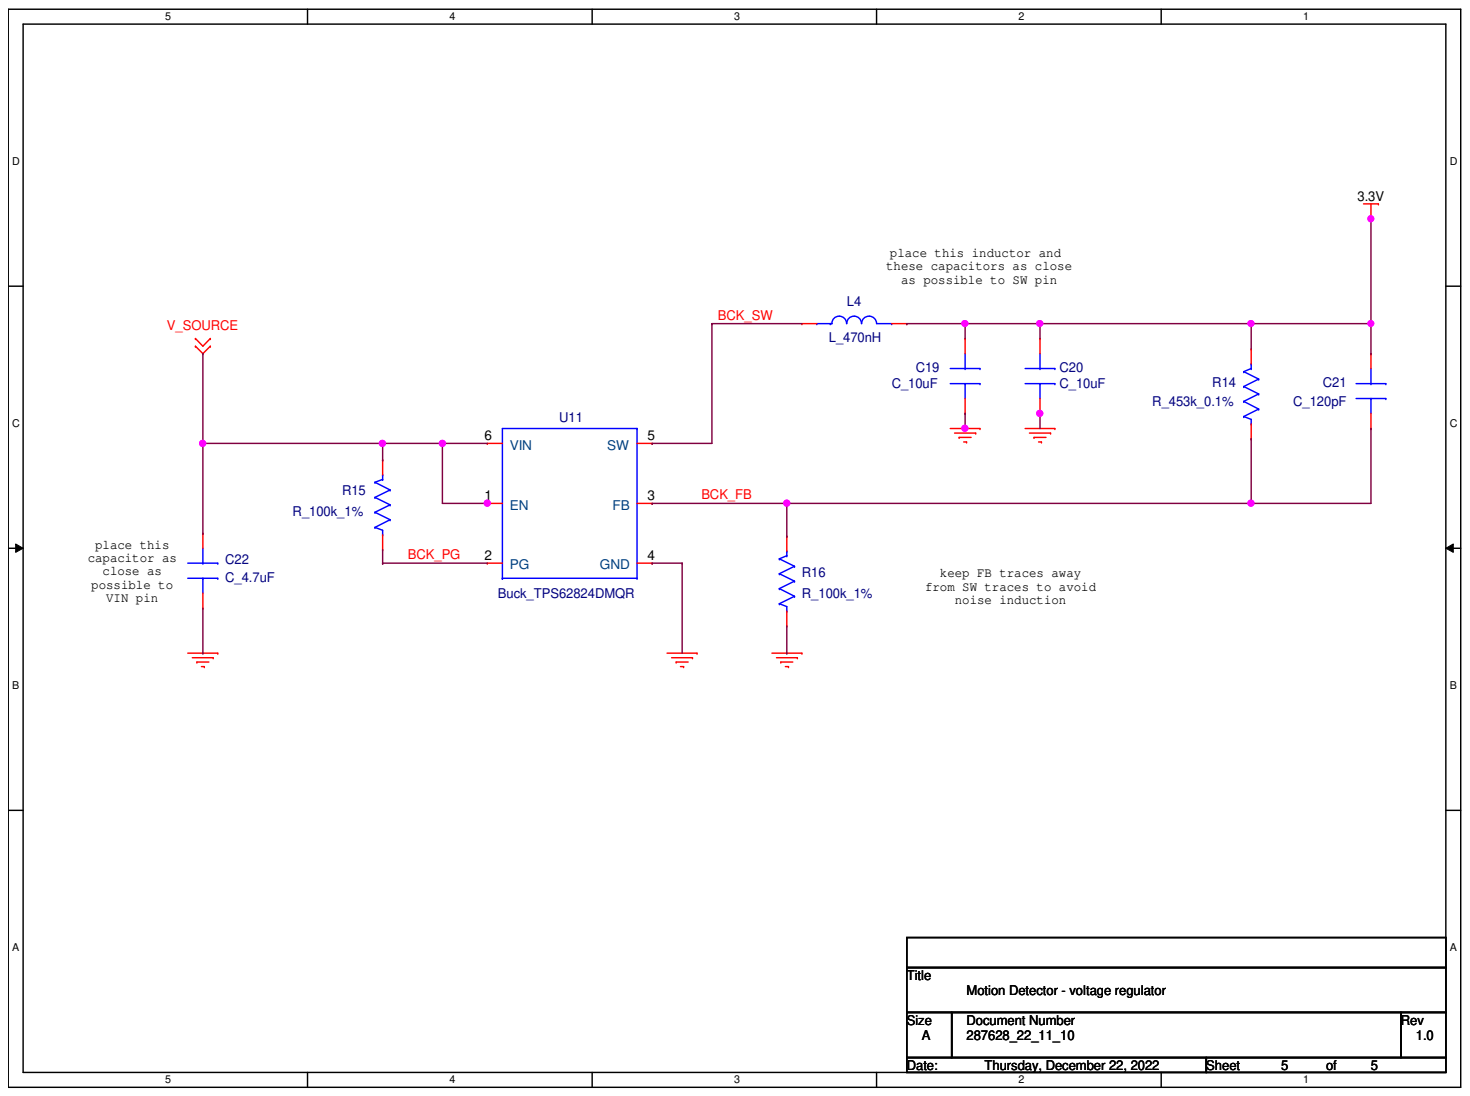
[picture p27: page 5]

place this inductor and
these capacitors as close
as possible to SW pin

keep FB traces away
from SW traces to avoid
noise induction

Motion Detector - voltage regulator
