AndreaBononi/MotionDetector/(list of files, drawings)

Other design files:
project/Motion_Detector/MOTION_DETECTOR.DSN
project/Motion_Detector/Motion_Detector.opj
project/OrCAD_Personal_Library/PERSONAL_BASE_SYMBOLS.OLB
project/OrCAD_Personal_Library/PERSONAL_SYMBOLS_1.OLB
project/OrCAD_Personal_Library/personal_symbols_1.opj
